marcellus987/mailbox-notification-device/README.md

# Mailbox Notification Device Project
Repository for my Mailbox Notification Device Project. Code for transmitter and receiver are placed under separate folder, namely "tx-" and "rx-".

The drivers used for all the hardware (STM32, SD card, RYLR689, SH1106 OLED display, and DS3231 RTC) used in this project were all ***customly made*** by **myself**. I did this for educational purpose; to practice reading and understanding datasheets.
Therefore, **keep in mind** that the drivers are **not** perfect; however, I did debugged it the best I can including the use of Logic Analyzer to monitor how the drivers interacted with the hardware. With that said, the custom drivers can be found under "custom-drivers" directory which is linked to a separate repository.

**<u>FYI</u>:** This project is currently ***In Progress***.
<hr>

## <u>Pins used (Transmitter STM32-blackpill)</u>:

### RYLR689 LoRa module:
- PA5: SCK
- PA6: MISO
- PA7: MOSI
- PA8: NSS (CS)
- PB0: RF CONTROL: RFSW_V1_PIN_POS
- PB1: RF CONTROL: RFSW_V2_PIN_POS
- PB5: BUSY
- PB8: RESET (Active-Low)
- PB9: DIO (Interrupt)

### IR beam transmitter and receiver sensor:
- PB10: IR beam receiver output (Pull-up required for MCU input pin).
- PB12: IR beam receiver power.
- PB13: IR beam transmitter power.

### For debug:
- PA2: UART TX
- PA3: UART RX
- PC13: User LED for debugging purposes.

<hr>

## <u>Pins used (Receiver STM32-blackpill)</u>:

### RYLR689 LoRa module:
- PA5: SCLK
- PA6: MISO
- PA7: MOSI
- PA8: NSS (CS)
- PB0: RF CONTROL: RFSW_V1_PIN_POS
- PB1: RF CONTROL: RFSW_V2_PIN_POS
- PB5: BUSY
- PB8: RESET (Active-Low)
- PB9: DIO (Interrupt)

### DS3231 (RTC module):
- PB6: SCL
- PB7: SDA

### SD-card module (SPI-based):
- PA1: CS
- PA5: SCLK
- PA6: MISO
- PA7: MOSI

### OLED Display (SPI-based):
- PA4: CS
- PA5: SCLK
- PA7: MOSI
- PB14: DC
- PB15: RESET (Active-Low)

## LED indication lights:
- PB12: Blue LED 
- PB13: Yellow LED
  
### For debug:
- PA2: UART TX
- PA3: UART RX
- PC13: User LED for debugging purposes.

<hr>

# Flow:
- **TBU**: I will update this with an image of a diagram, typing it is not easy.

<hr>

# Demo:

### RX side Image(s):

**<u>Components:<u>**
- STM32F411CEU (blackpill), RYLR689 LoRa module, SD card module, DS3231 RTC module, OLED SH1106 module, Power supply, 9v Battery.
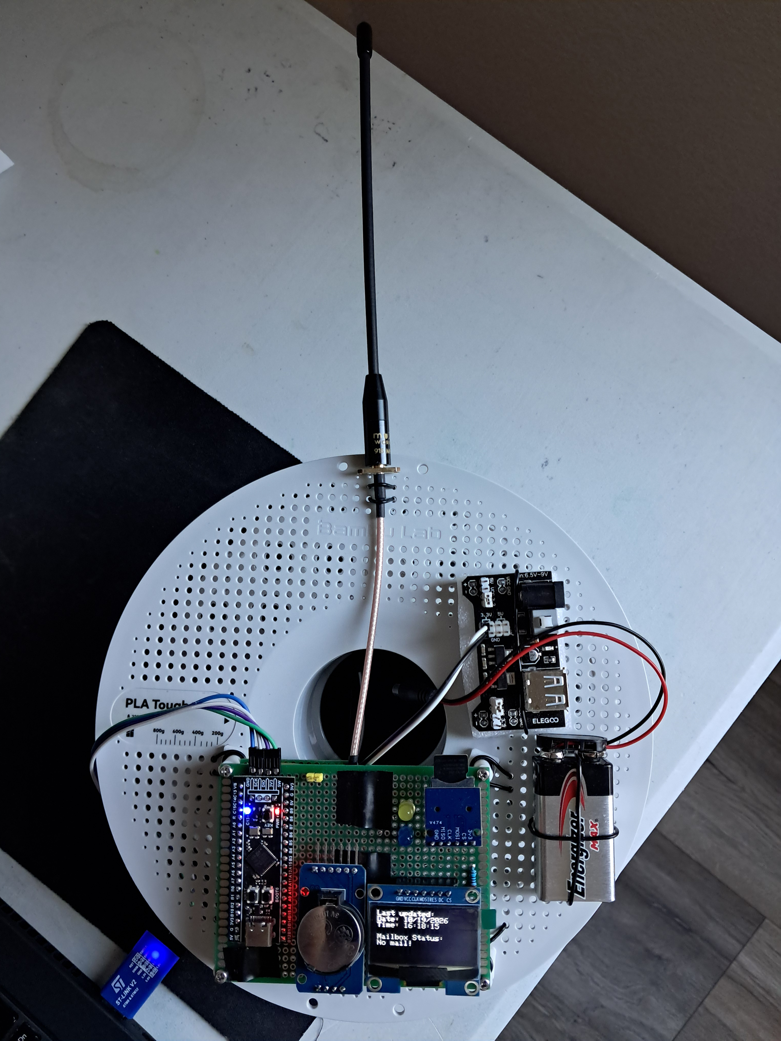
[picture p1: demo/images/rx_device_images/rx-setup.jpg]
Components used for RX device in this project.


**<u>Wirings:<u>**
- ***Note:*** The solder blobs you would see here were intentionally done for better contact.
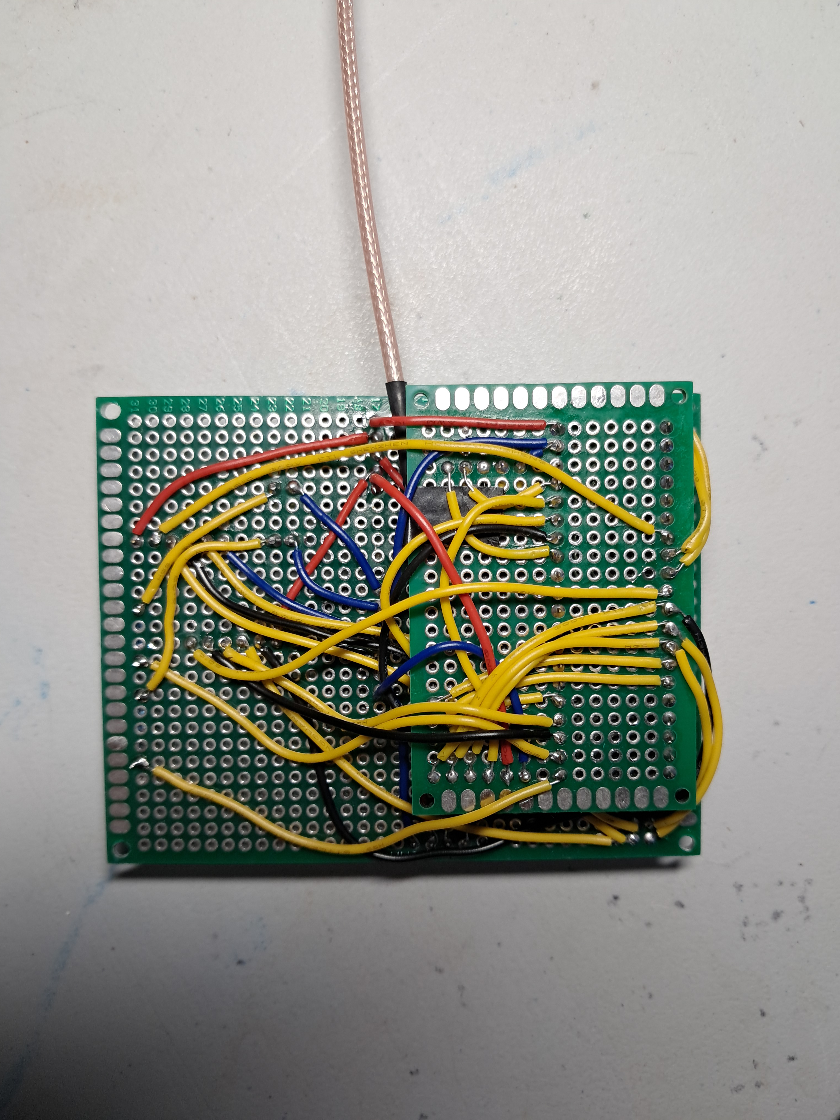
[picture p2: hardware/rx-dev-wirings.jpg]
Wirings of RX device.


**<u>Initial Status: No mail.<u>**
This is initial status at boot.


**<u>Updated Status: New mail arrived!<u>**
This is the demo when new mail arrives.


**<u>Updated Status: Old and possibly new mail inside the mailbox!<u>**
This is the demo when old and possibly new mail is inside the mailbox.


### TX side Image(s):

**<u>Components:<u>**
- STM32F411CEU (blackpill), RYLR689 LoRa module, SD card module, IR transmitter-receiver, Reed switch (Normally open, will be replaced with "Normally closed" version in the future).
- When deployed in an actual Mailbox, the IR sensor will be placed on the sides of the mailbox while the Reed switch will be placed on the mailbox lid to detect when it opens.
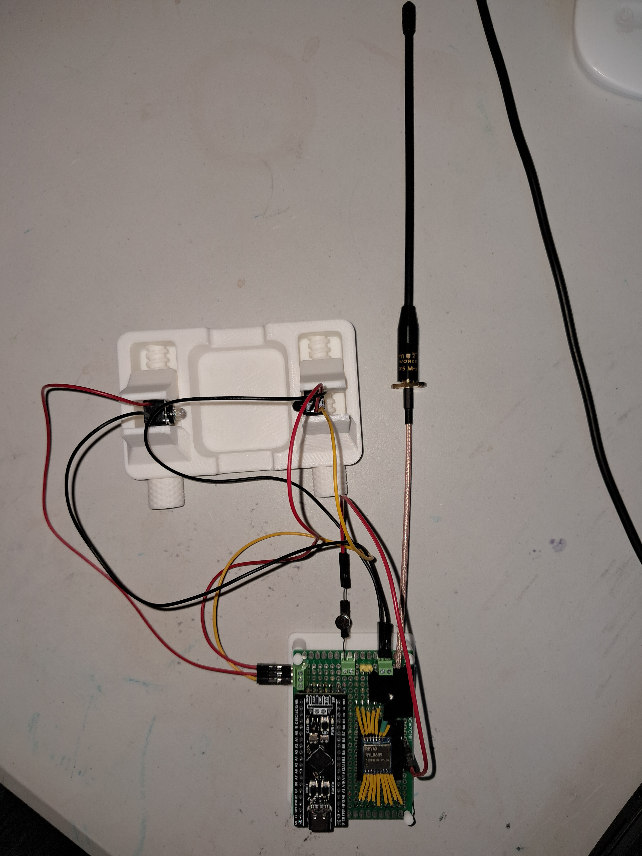
[picture p6: demo/images/tx_device_images/tx_setup.jpg]
Components for TX device used in this project.


**<u>Wirings:<u>**
- ***Note:*** The solder blobs you would see here were intentionally done for better contact.
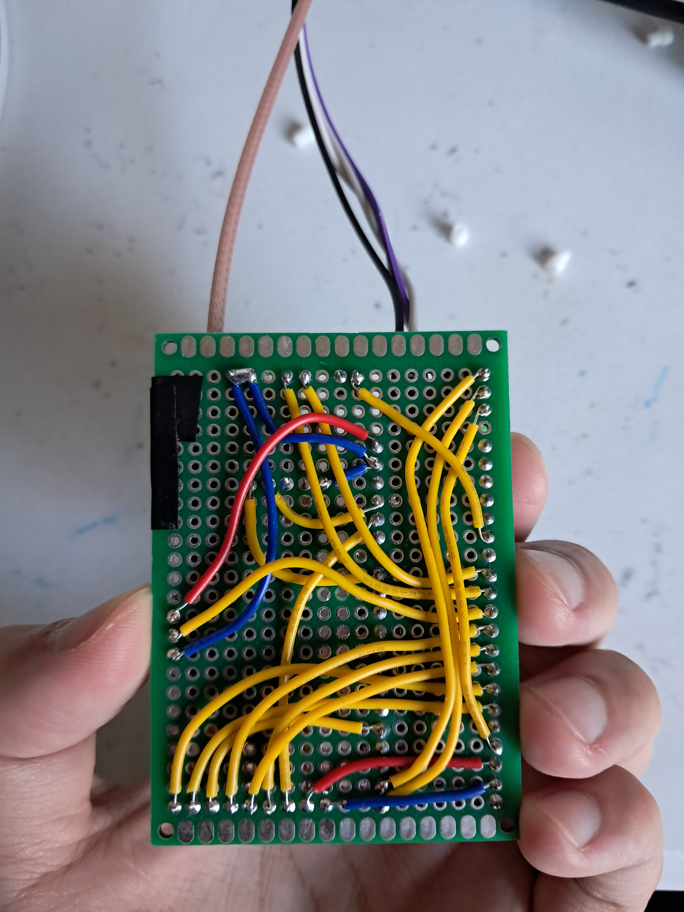
[picture p7: hardware/tx-dev-wirings.jpg]
Wirings of TX device.


**<u>IR-sensor and Reed switch:<u>**
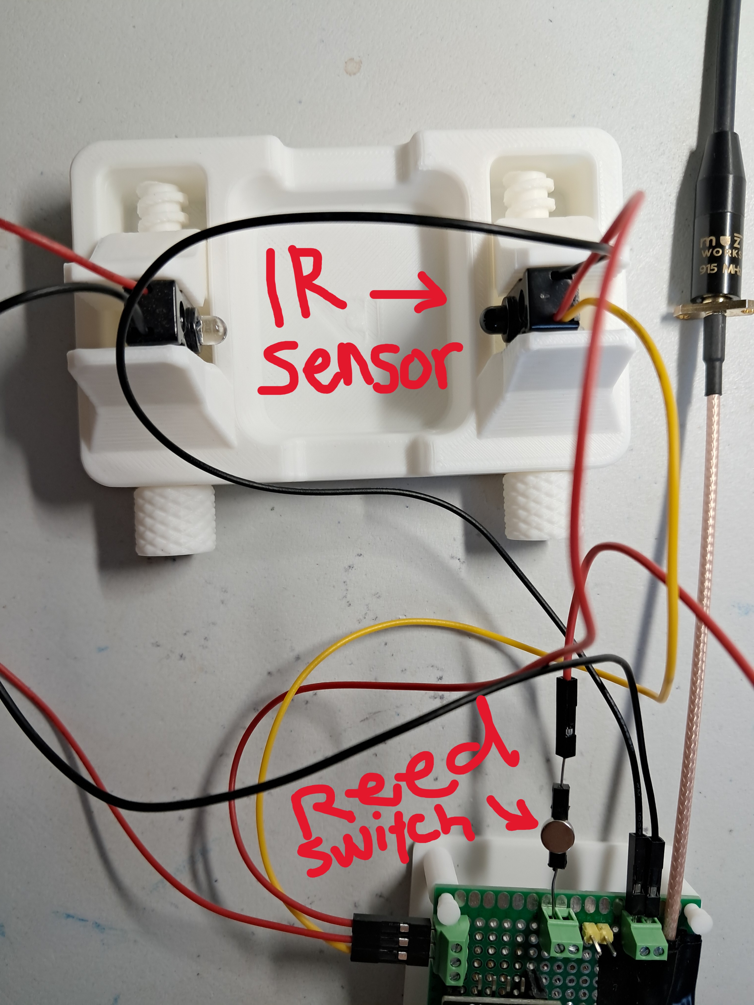
[picture p8: demo/images/tx_device_images/tx_ir_sensor_close_up_md.jpg]
Close-up image of the IR sensor used in this project.


### Video(s):
- **TBU**: I will post a simple demonstration video here.
