marcellus987/mailbox-notification-device/demo/images/tx_device_images/tx_close_up.jpg

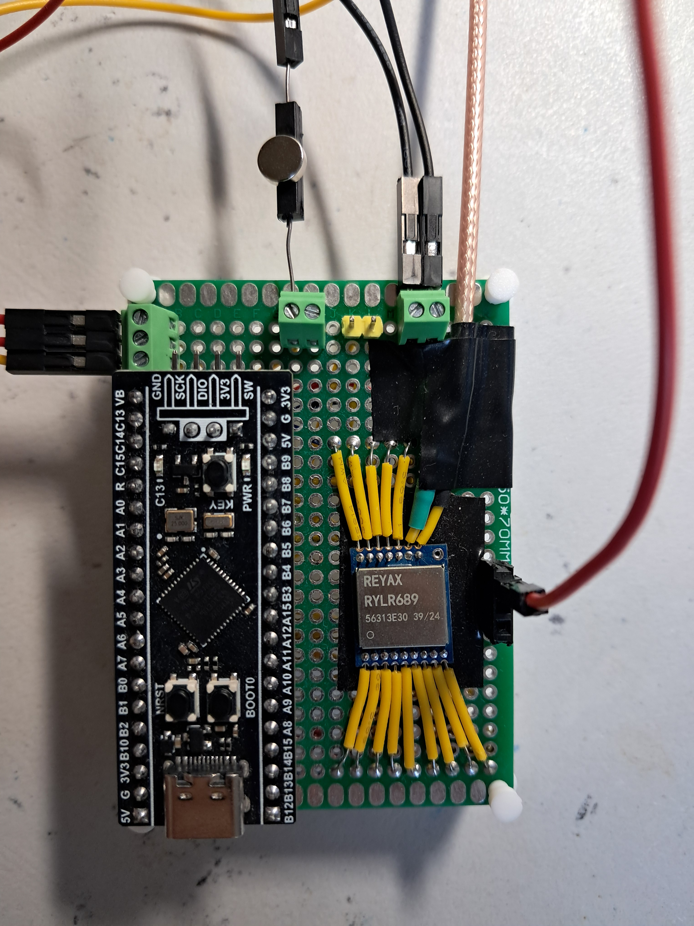
demo/images/tx_device_images/tx_close_up.jpg
