marcellus987/mailbox-notification-device/demo/images/tx_device_images/tx_setup_closeup.jpg

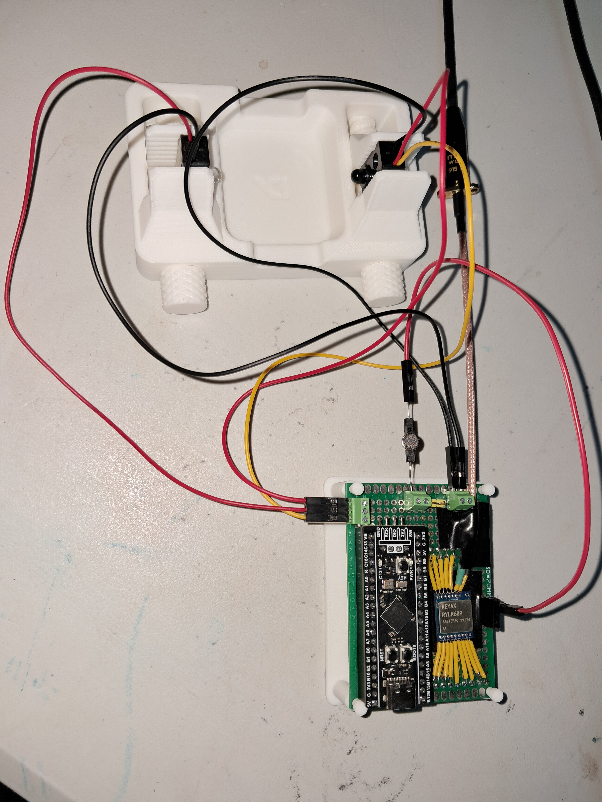
demo/images/tx_device_images/tx_setup_closeup.jpg
