marcellus987/mailbox-notification-device/rx-firmware/Core/Src/main.c

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
/* Includes ------------------------------------------------------------------*/
#include "main.h"

/* USER CODE BEGIN Includes */
#include "rylr689_driver.h"
#include "ds3231_driver.h"
#include "stm32_commons.h"
#include "sdCard_driver.h"
#include "ff.h"
#include "oled_sh1106_driver.h"
#include <string.h>


/* USER CODE END Includes */

/* USER CODE BEGIN PD */
#define LAST_UPDATE_HEADER_LINE		0
#define DATE_HEADER_LINE 			1
#define TIME_HEADER_LINE 			2
#define MAIL_STATUS_HEADER_LINE 	4
#define MAIL_MSG_LINE_START 		5
#define MAIL_MSG_LINE_END 			7
#define MISSED_NOTIFICATION_LIMIT	3
#define RTC_BASE_CENTURY			2000

#define TIME_FORMAT_WIDTH 8 /* HH:MM:SS -> 10 characters. */
#define DATE_FORMAT_WIDTH 10 /* MM:DD:YYYY -> 10 characters. */
#define MAILBOX_RXTX_MAGIC_NUMBER 0xDEADBEEFU

/* USER CODE END PD */

I2C_HandleTypeDef hi2c1;

RTC_HandleTypeDef hrtc;

SPI_HandleTypeDef hspi1;

UART_HandleTypeDef huart2;

/* USER CODE BEGIN PV */

sdCard_instance_t sdCardDev;

/* USER CODE END PV */

void SystemClock_Config(void);
static void MX_GPIO_Init(void);
static void MX_SPI1_Init(void);
static void MX_USART2_UART_Init(void);
static void MX_I2C1_Init(void);
static void MX_RTC_Init(void);
/* USER CODE BEGIN PFP */
static void rylry689_radio_init(rylr689_instance_t *dev, uint8_t *buffer);
static void sh1106_oled_init(oled_sh1106_instance_t *dev);
static void ds3231_rtc_init(ds3231_instance_t *dev);
static void sdCard_global_init(void);
static void syncIntRTCPeriphToExtRTC(ds3231_instance_t *dev);

static void getDateTime(RTC_TimeTypeDef *curTime, RTC_DateTypeDef *curDate);

/* USER CODE END PFP */

/* USER CODE BEGIN 0 */
typedef enum {
	STATE_APP_START = 0,
	STATE_SLEEP_ON_WAIT,
	STATE_ON_RECEIVE
} app_state_t;

typedef enum {
	MAIL_ABSENT = 0,
	MAIL_PRESENT,
	MAIL_MISSED_INITIAL_NOTIFICATION
} mail_state_t;

volatile app_state_t appState = STATE_APP_START;

/* USER CODE END 0 */

/**
  * @brief  The application entry point.
  * @retval int
  */
int main(void)
{

  /* MCU Configuration--------------------------------------------------------*/

  /* Reset of all peripherals, Initializes the Flash interface and the Systick. */
  HAL_Init();

  /* Configure the system clock */
  SystemClock_Config();

  /* Initialize all configured peripherals */
  MX_GPIO_Init();
  MX_SPI1_Init();
  MX_USART2_UART_Init();
  MX_I2C1_Init();
  MX_RTC_Init();
  /* USER CODE BEGIN 2 */

	/* Oled module START. */
	oled_sh1106_instance_t oled1;
	sh1106_oled_init(&oled1);
	/* Oled module END. */

	/* RTC module START. */
	ds3231_instance_t rtc1;
	ds3231_rtc_init(&rtc1);
	/* Update MCU RTC peripheral to avoid constantly querying ds3231 module. */
	syncIntRTCPeriphToExtRTC(&rtc1);

	RTC_TimeTypeDef curTime = {0};
	RTC_DateTypeDef curDate = {0};
	getDateTime(&curTime, &curDate);
	/* RTC module END. */

    /* SD card module START. */
	sdCard_global_init(); /* Initialize SD card. */

	FATFS fs;   /* File system. */
	FIL file;   /* File handler. */
	FRESULT res; /* Result from file function calls. */
	UINT br; /* Bytes read from file. */
	UINT bw; /* Bytes written to file. */


	/* Original files will have only the date stamp. If this file exist but the header
	 * did not match, create a new file with time stamp.
	 *
	 * The limitation is that when the original fails. Then each boot up for the current
	 * date will create new files with new time stamp. To avoid this, one possible solution
	 * is to create a backup file for failing files, then reuse the original filename. This way
	 * file creation can be reduced. The down-side is that creating a backup may take time if
	 * original file is large.
	 *
	 * */
	char filename[30];
	char header[] = "Date: [mm-dd-yyyy],Time (24-hour format): [hh-mm-ss],Status:\r\n";
	uint32_t headerLen = strlen(header);

	res = f_mount(&fs, "",0);

	snprintf(filename, 29, "mailbox_log_%04u-%02u-%02u.csv", \
			(curDate.Year + RTC_BASE_CENTURY), curDate.Month, curDate.Date);
	uint32_t startTime = HAL_GetTick();

	/* Open file for current date. */
	while((res = f_open(&file, filename, FA_WRITE | FA_READ | FA_OPEN_APPEND)) != FR_OK) {
		if((HAL_GetTick() - startTime) > SD_TIMEOUT) {
			char *errMsg = "SD card error! Failed to mount file system!";
			sh1106_setAtCharacter(&oled1, LAST_UPDATE_HEADER_LINE, 0);
			sh1106_write_line(&oled1, errMsg, strlen(errMsg));
			Error_Handler();
		}
	}

	/* Check if file is empty. If not check if header exist. */
	if(f_size(&file) > 0) {
		char testRead[headerLen];
		/* Set cursor to beginning. Then perform a read. */
		f_lseek(&file, 0);
		res = f_read(&file, testRead, headerLen, &br);

		/* 1st Method of handling failing files. */
		/* No matching header. Create new file for same date but with timestamp. */
		if(memcmp((char*)testRead, header, headerLen) != 0) {
			FIL tempFile;
			char tempFilename[FF_MAX_LFN];
			uint8_t readBuff[512];
			UINT bytesRead;
			UINT bytesWritten;
			FSIZE_t bytesCopied = 0;
			FSIZE_t bytesRemaining = f_size(&file); /* Though f_size() returns uint64_t, it may be unrealistic
																	  for a CSV file to be that large. So, only the lower 32-bit
																	  will be used for now. */

			char msgDspBuff[50] = "Error with log file! Performing backup...";
			char *bytesRemHeader = "Bytes remaining: ";
			char *bytesCopHeader = "Bytes copied: ";

			uint8_t oldBytesRemValBuffLen;
			uint8_t oldBytesCopValBuffLen;

			sh1106_setAtCharacter(&oled1, LAST_UPDATE_HEADER_LINE, 0);
			sh1106_write_line(&oled1, msgDspBuff, strlen(msgDspBuff));

			/* Line #2. */
			sprintf(msgDspBuff, "File size: %lu", (uint32_t)bytesRemaining);
			sh1106_setAtCharacter(&oled1, LAST_UPDATE_HEADER_LINE + 2, 0);
			sh1106_write_line(&oled1, msgDspBuff, strlen(msgDspBuff));

			/* Line #4. */
			sh1106_setAtCharacter(&oled1, LAST_UPDATE_HEADER_LINE + 3, 0);
			sh1106_write_line(&oled1, bytesRemHeader, strlen(bytesRemHeader));
			sprintf(msgDspBuff, "%lu", (uint32_t)bytesRemaining);
			sh1106_setAtCharacter(&oled1, LAST_UPDATE_HEADER_LINE + 4, 0);
			sh1106_write_line(&oled1, msgDspBuff, strlen(msgDspBuff));
			oldBytesRemValBuffLen = strlen(msgDspBuff);

			/* Line #5. */
			sh1106_setAtCharacter(&oled1, LAST_UPDATE_HEADER_LINE + 5, 0);
			sh1106_write_line(&oled1, bytesCopHeader, strlen(bytesCopHeader));
			sprintf(msgDspBuff, "%lu", (uint32_t)bytesCopied);
			sh1106_setAtCharacter(&oled1, LAST_UPDATE_HEADER_LINE + 6, 0);
			sh1106_write_line(&oled1, msgDspBuff, strlen(msgDspBuff));
			oldBytesCopValBuffLen = strlen(msgDspBuff);

			getDateTime(&curTime, &curDate);

			/* Filename format: mail_log_YYYY-MM-DD_hh-mm-ss.csv. */
			snprintf(tempFilename, FF_MAX_LFN, "bak_failing_log_%04u-%02u-%02u_%02u-%02u-%02u.csv", \
					(curDate.Year + RTC_BASE_CENTURY), curDate.Month, curDate.Date, \
					 curTime.Hours, curTime.Minutes, curTime.Seconds);

			f_open(&tempFile, tempFilename, (FA_WRITE | FA_READ | FA_OPEN_APPEND));

			/* Set cursor to beginning of original file. Then perform a read. */
			f_lseek(&file, 0);

			while(bytesRemaining > bytesCopied) {
				f_read(&file, readBuff, 512, &bytesRead);
				f_write(&tempFile, readBuff, bytesRead, &bytesWritten);
				f_sync(&tempFile);
				bytesCopied += bytesWritten;

				/* Display bytes remaining to be copied. */
				sprintf(msgDspBuff, "%lu", (uint32_t)(bytesRemaining - bytesCopied));


				if(oldBytesRemValBuffLen > strlen(msgDspBuff)) {
				  memset((msgDspBuff + strlen(msgDspBuff)), ' ', oldBytesRemValBuffLen - strlen(msgDspBuff));
				}
				sh1106_setAtCharacter(&oled1, LAST_UPDATE_HEADER_LINE + 4, 0);
				sh1106_write_line(&oled1, msgDspBuff, strlen(msgDspBuff));

				/* Display bytes copied. */
				sprintf(msgDspBuff, "%lu", (uint32_t)bytesCopied);
				if(oldBytesCopValBuffLen > strlen(msgDspBuff)) {
				  memset((msgDspBuff + strlen(msgDspBuff)), ' ', oldBytesCopValBuffLen - strlen(msgDspBuff));
				}
				sh1106_setAtCharacter(&oled1, LAST_UPDATE_HEADER_LINE + 6, 0);
				sh1106_write_line(&oled1, msgDspBuff, strlen(msgDspBuff));
			}
			sh1106_clearScreen(&oled1);

			f_close(&tempFile);

			/* Set cursor to beginning of original file. Then delete its contents, keeping file open. */
			f_lseek(&file, 0);
			f_truncate(&file);
			f_write(&file, header, headerLen, &bw);
			f_sync(&file);
		}
		else {
			/* Move back the cursor to EOF. To prepare for possible file write operations. */
			f_lseek(&file, f_size(&file));
		}

//		/* 2nd method. */
//		/* No matching header. Create new file for same date but with timestamp. */
//		if(memcmp((char*)testRead, header, headerLen) != 0) {
//			f_close(&file); /* Close current file. */
//
//			char tempFilename[FF_MAX_LFN];
//			getDateTime(&curTime, &curDate);
//			/* Filename format: mail_log_YYYY-MM-DD_hh-mm-ss.csv. */
//			snprintf(tempFilename, FF_MAX_LFN, "mailbox_log_%04u-%02u-%02u_%02u-%02u-%02u.csv", \
//					(curDate.Year + RTC_BASE_CENTURY), curDate.Month, curDate.Date, \
//					 curTime.Hours, curTime.Minutes, curTime.Seconds);
//			f_open(&file, tempFilename, (FA_WRITE | FA_READ | FA_OPEN_APPEND));
//			res = f_write(&file, header, headerLen, &bw);
//			f_sync(&file);
//		}
//		else {
//			/* Move back the cursor to EOF. To prepare for possible file write operations. */
//			f_lseek(&file, fileSize);
//		}
	}
	else {
		res = f_write(&file, header, headerLen, &bw);
		f_sync(&file);
	}

//	/* For debug. */
//	f_close(&file);
//	HAL_GPIO_WritePin(YELLOW_LED_GPIO_Port, YELLOW_LED_Pin, GPIO_PIN_SET);
//	HAL_GPIO_WritePin(BLUE_LED_GPIO_Port, BLUE_LED_Pin, GPIO_PIN_SET);
	/* SD card module END. */

	HAL_GPIO_WritePin(BUILT_IN_LED_GPIO_Port, BUILT_IN_LED_Pin, GPIO_PIN_RESET);

	/* Radio module START. */
	uint8_t status[256];
	rylr689_instance_t radio1;
	rylry689_radio_init(&radio1, status);
	uint32_t packetSizeReceived;
	/* Radio module END. */


	char msg[50];

	/* +1 for null character. */
	char dateBuff[DATE_FORMAT_WIDTH + 1];
	char timeBuff[TIME_FORMAT_WIDTH + 1];

	char* lastUpdateHeader = "Last updated:";
	char *dateHeader = "Date: ";
	char *timeHeader = "Time: ";
	char *mailHeader = "Mailbox Status: ";

	/* Write headers to designated lines. */
	sh1106_setAtCharacter(&oled1, LAST_UPDATE_HEADER_LINE, 0);
	sh1106_write_line(&oled1, lastUpdateHeader, strlen(lastUpdateHeader));

	sh1106_setAtCharacter(&oled1, DATE_HEADER_LINE, 0);
	sh1106_write_line(&oled1, dateHeader, strlen(dateHeader));

	sh1106_setAtCharacter(&oled1, TIME_HEADER_LINE, 0);
	sh1106_write_line(&oled1, timeHeader, strlen(timeHeader));

	sh1106_setAtCharacter(&oled1, MAIL_STATUS_HEADER_LINE, 0);
	sh1106_write_line(&oled1, mailHeader, strlen(mailHeader));

	snprintf(dateBuff, DATE_FORMAT_WIDTH + 1,"%02u/%02u/%04u", curDate.Month, curDate.Date, (uint16_t)curDate.Year + RTC_BASE_CENTURY);
	snprintf(timeBuff, TIME_FORMAT_WIDTH + 1, "%02u:%02u:%02u", curTime.Hours, curTime.Minutes, curTime.Seconds);

	/* Go back to date line. */
	sh1106_setAtCharacter(&oled1, DATE_HEADER_LINE, strlen(dateHeader));
	sh1106_write_line(&oled1, dateBuff, strlen(dateBuff));

	/* Go back to time line. */
	sh1106_setAtCharacter(&oled1, TIME_HEADER_LINE, strlen(timeHeader));
	sh1106_write_line(&oled1, timeBuff, strlen(timeBuff));

	/* Go to message line. */
	sh1106_setAtCharacter(&oled1, MAIL_MSG_LINE_START, 0);

	sprintf(msg, "No mail!");
	sh1106_write_line(&oled1, msg, strlen(msg));

	uint8_t oldStatus = MAIL_ABSENT;
	uint8_t oldMsgLen = strlen(msg);
	RTC_DateTypeDef savedDate = curDate;



  /* USER CODE END 2 */

  /* Infinite loop */
  /* USER CODE BEGIN WHILE */

  while (1) {
	  switch(appState) {
		  case STATE_APP_START:
			  rylr689_radio_receive_it(&radio1);
			  appState = STATE_SLEEP_ON_WAIT;
			  break;
		  case STATE_SLEEP_ON_WAIT:
			  /* Put device to sleep. Do not change the status here. Only ISR can change the status upon receiving packet.
			   * For now, radio will be ON while MCU is in STOP mode waiting for interrupt from radio. */

			  /* Set to STOP mode here. MCU may wake up from non-radio related wake-up signal, but will be
			   * handled by the application's state.  */
//			  enterStopMode();
//
//			  /* Sleeps... */
//
//			  /* Recover*/
//			  SystemClock_Config();
//			  HAL_ResumeTick();
//
//			  /* Clear wake up flag for clean sleep state after waking. */
//			  clearWakeUpFlags();

			  break;
		  case STATE_ON_RECEIVE:

			  /* Fetch packet. */
			  rylr689_radio_get_packet(&radio1, &packetSizeReceived);

			  /* Packet must be 5 bytes. */
			  if(packetSizeReceived != sizeof(uint32_t) + 1) {
				  Error_Handler();
			  }

			  uint32_t magicVal;
			  /* Skip first bytes then copy the last four bytes. */
			  memcpy(&magicVal, radio1.rxBuff + 1, sizeof(uint32_t));

			  if(magicVal != MAILBOX_RXTX_MAGIC_NUMBER) {
				  Error_Handler();
			  }

			  getDateTime(&curTime, &curDate);
			  /* Update date only when it is different. */
			  if((curDate.Month != savedDate.Month) || (curDate.Date != savedDate.Date ) || (curDate.Year != savedDate.Year)) {
				  	  savedDate = curDate;
					  /* Go back to Date header line. */
					  sh1106_setAtCharacter(&oled1, DATE_HEADER_LINE, strlen(dateHeader));
					  snprintf(dateBuff, DATE_FORMAT_WIDTH + 1,"%02u/%02u/%04u", curDate.Month, curDate.Date, (uint16_t)curDate.Year + RTC_BASE_CENTURY);
					  sh1106_write_line(&oled1, dateBuff, DATE_FORMAT_WIDTH);
			  }

			  /* Go back to Time header line and update time every second. */
			  sh1106_setAtCharacter(&oled1, TIME_HEADER_LINE, strlen(timeHeader));
			  snprintf(timeBuff, TIME_FORMAT_WIDTH + 1, "%02u:%02u:%02u", curTime.Hours, curTime.Minutes, curTime.Seconds);
			  sh1106_write_line(&oled1, timeBuff, TIME_FORMAT_WIDTH);

			  /* Check mailbox status. */
			  switch(status[0]) {
				  case 0:
					  sprintf(msg, "No mail!");
					  HAL_GPIO_WritePin(YELLOW_LED_GPIO_Port, YELLOW_LED_Pin, GPIO_PIN_SET);
					  HAL_GPIO_WritePin(BLUE_LED_GPIO_Port, BLUE_LED_Pin, GPIO_PIN_RESET);
					  break;
				  case 1:
					  sprintf(msg, "New mail arrived!");
					  HAL_GPIO_WritePin(YELLOW_LED_GPIO_Port, YELLOW_LED_Pin, GPIO_PIN_RESET);
					  HAL_GPIO_WritePin(BLUE_LED_GPIO_Port, BLUE_LED_Pin, GPIO_PIN_SET);
					  break;
				  case 2:
					  sprintf(msg, "Old and possibly new mail inside mailbox!");
					  HAL_GPIO_WritePin(YELLOW_LED_GPIO_Port, YELLOW_LED_Pin, GPIO_PIN_SET);
					  HAL_GPIO_WritePin(BLUE_LED_GPIO_Port, BLUE_LED_Pin, GPIO_PIN_SET);
					  break;
				  default:
					  /* For testing only. */
					  sprintf(msg, "False alarm!");
					  HAL_GPIO_WritePin(YELLOW_LED_GPIO_Port, YELLOW_LED_Pin, GPIO_PIN_RESET);
					  HAL_GPIO_WritePin(BLUE_LED_GPIO_Port, BLUE_LED_Pin, GPIO_PIN_RESET);
			  }
			  /* For debug. */
			  HAL_UART_Transmit(&huart2, (uint8_t*)msg, strlen(msg), 100);

			  char log[101];
			  snprintf(log, 100, "%02u/%02u/%04u,%02u:%02u:%02u,%s\r\n", \
					   curDate.Month, curDate.Date, (uint16_t)curDate.Year + RTC_BASE_CENTURY, \
					   curTime.Hours, curTime.Minutes, curTime.Seconds, msg);

			  f_write(&file, log, strlen(log), &bw);
			  f_sync(&file);

			/* Go to message line. Update only if status has changed.*/
			if(status[0] != oldStatus) {
				uint8_t newMsgLen = strlen(msg);

				/* For erasing left-over characters from old message, if necessary. */
				if(oldMsgLen > newMsgLen) {
					memset((msg + newMsgLen), ' ', oldMsgLen - newMsgLen);
				}

				/* Set cursor for the new message and write new message. */
				sh1106_setAtCharacter(&oled1, MAIL_MSG_LINE_START, 0);
				sh1106_write_line(&oled1, msg, (oldMsgLen > newMsgLen) ? oldMsgLen : newMsgLen);

				/* Update "new" old. */
				oldStatus = status[0];
				oldMsgLen = newMsgLen;
			}
			/* Reset state. */
			appState = STATE_APP_START;
			break;
		  default:
			  /* Do nothing. */
	  }
  }

    /* USER CODE END WHILE */

}

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
/* USER CODE BEGIN 4 */

/* For FATFS. */
DWORD get_fattime (void) {
	RTC_TimeTypeDef curTime;
	RTC_DateTypeDef curDate;
	getDateTime(&curTime, &curDate);

	return (((curDate.Year + RTC_BASE_CENTURY) - 1980) << 25) | \
			(curDate.Month << 21) | (curDate.Date << 16) | \
			(curTime.Hours << 11) | (curTime.Minutes << 5) | \
			(curTime.Seconds >> 1);
}



static void getDateTime(RTC_TimeTypeDef *curTime, RTC_DateTypeDef *curDate) {
	/* Must be called in sequence per HAL documentation.
	 * The RTC_FORMAT_BIN converts the native BCD format to binary
	 * representation of the value. This will give us the actual
	 * number for each field. */
	HAL_RTC_GetTime(&hrtc, curTime, RTC_FORMAT_BIN);
	HAL_RTC_GetDate(&hrtc, curDate, RTC_FORMAT_BIN);
}

static void sdCard_global_init(void) {
	sdCardDev.csPin.port = SD_CARD_CS_GPIO_Port;
	sdCardDev.csPin.pin = SD_CARD_CS_Pin;
	sdCardDev.pinRead = wrapper_pin_read;
	sdCardDev.pinWrite = wrapper_pin_write;
	sdCardDev.delay = wrapper_delay;
	sdCardDev.spiHandle = &hspi1;
	sdCardDev.spiTransmitReceive = wrapper_spi_transmit_receive;
	sdCardDev.spiTransmit = wrapper_spi_transmit;
	sdCardDev.getState = wrapper_get_spi_state;
	sdCardDev.setBaudrate = wrapper_sdCard_spi_setBaudrate;
	sdCardDev.initialized = 0;

	xSd_Init(&sdCardDev);
}

static void rylry689_radio_init(rylr689_instance_t *dev, uint8_t *buffer) {
	dev->csPin.pin = LoRa_Module_CS_Pin;
	dev->csPin.port = LoRa_Module_CS_GPIO_Port;
	dev->busyPin.pin = LoRa_Module_Busy_Pin;
	dev->busyPin.port = LoRa_Module_Busy_GPIO_Port;
	dev->nresetPin.pin = LoRa_Module_NRESET_Pin;
	dev->nresetPin.port = LoRa_Module_NRESET_GPIO_Port;
	dev->itPin.pin = LoRa_Module_DIOQ_Pin;
	dev->itPin.port = LoRa_Module_DIOQ_GPIO_Port;
	dev->rfswV1Pin.pin = LoRa_Module_RFSW_V1_PIN_POS_Pin;
	dev->rfswV1Pin.port = LoRa_Module_RFSW_V1_PIN_POS_GPIO_Port;
	dev->rfswV2Pin.pin = LoRa_Module_RFSW_V2_PIN_POS_Pin;
	dev->rfswV2Pin.port = LoRa_Module_RFSW_V2_PIN_POS_GPIO_Port;
	dev->pinWrite = wrapper_pin_write;
	dev->pinRead = wrapper_pin_read;
	dev->spiHandle = &hspi1;
	dev->spiReceive = wrapper_spi_receive;
	dev->spiTransmit = wrapper_spi_transmit;
	dev->rxBuff = buffer;
	dev->rxBuffSize = RX_BUFF_SIZE;
	dev->txBuff = buffer;
	dev->txBuffSize = TX_BUFF_SIZE;
	dev->initialized = 0;

	rylr689_radio_init(dev);

}
static void sh1106_oled_init(oled_sh1106_instance_t *dev) {
	dev->cs.port = OLED_CS_GPIO_Port;
	dev->cs.pin = OLED_CS_Pin;
	dev->dc.port = OLED_DC_GPIO_Port;
	dev->dc.pin = OLED_DC_Pin;
	dev->nreset.port = OLED_NRESET_GPIO_Port;
	dev->nreset.pin = OLED_NRESET_Pin;
	dev->gpio_write = wrapper_pin_write;
	dev->delay_ms = wrapper_delay;
	dev->spiHandle = &hspi1;
	dev->spiTransmit = wrapper_spi_transmit;
	dev->initialized = 0;

	sh1106_init(dev);
}

static void ds3231_rtc_init(ds3231_instance_t *dev) {
	dev->i2cHandle = &hi2c1;
	dev->i2cTransmit = wrapper_i2c_transmit_repeat_start;
	dev->i2cReceive = wrapper_i2c_receive_repeat_start;
	dev->baseCentury = RTC_BASE_CENTURY;
	dev->initialized = 0;

	ds3231_rtc_module_init(dev);
}

static void syncIntRTCPeriphToExtRTC(ds3231_instance_t *dev) {

	RTC_TimeTypeDef sTime = {0};
	RTC_DateTypeDef sDate = {0};
	raw_date_t rDate;
	raw_time_t rTime;

	/* Already in BCD, when calling HAL, use the RTC_FORMAT_BCD option. */
	ds3231_getRawCurrentDate(dev, &rDate);
	ds3231_getRawCurrentTime(dev, &rTime);

	sTime.Hours = rTime.hours;
	sTime.Minutes = rTime.minutes;
	sTime.Seconds = rTime.seconds;
	sTime.DayLightSaving = RTC_DAYLIGHTSAVING_NONE;
	sTime.StoreOperation = RTC_STOREOPERATION_RESET;

	if (HAL_RTC_SetTime(&hrtc, &sTime, RTC_FORMAT_BCD) != HAL_OK)
	{
		Error_Handler();
	}

	sDate.WeekDay = rDate.dayOfWeek;
	sDate.Month = rDate.month;
	sDate.Date = rDate.date;
	sDate.Year = rDate.year;

	if (HAL_RTC_SetDate(&hrtc, &sDate, RTC_FORMAT_BCD) != HAL_OK)
	{
		Error_Handler();
	}
}



void HAL_GPIO_EXTI_Callback(uint16_t GPIO_Pin) {
//	UNUSED(GPIO_Pin);
	appState = STATE_ON_RECEIVE;
}
/* USER CODE END 4 */
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
