marcellus987/mailbox-notification-device/tx-firmware/Core/Inc/main.h

#define BUILT_IN_LED_Pin GPIO_PIN_13
#define BUILT_IN_LED_GPIO_Port GPIOC
#define LoRa_Module_RFSW_V1_PIN_POS_Pin GPIO_PIN_0
#define LoRa_Module_RFSW_V1_PIN_POS_GPIO_Port GPIOB
#define LoRa_Module_RFSW_V2_PIN_POS_Pin GPIO_PIN_1
#define LoRa_Module_RFSW_V2_PIN_POS_GPIO_Port GPIOB
#define IR_BEAM_OUT_Pin GPIO_PIN_10
#define IR_BEAM_OUT_GPIO_Port GPIOB
#define IR_BEAM_REC_PWR_Pin GPIO_PIN_12
#define IR_BEAM_REC_PWR_GPIO_Port GPIOB
#define IR_BEAM_TRANS_PWR_Pin GPIO_PIN_13
#define IR_BEAM_TRANS_PWR_GPIO_Port GPIOB
#define LoRa_Module_CS_pin_Pin GPIO_PIN_8
#define LoRa_Module_CS_pin_GPIO_Port GPIOA
#define LoRa_Module_Busy_pin_Pin GPIO_PIN_5
#define LoRa_Module_Busy_pin_GPIO_Port GPIOB
#define LoRa_Module_NRESET_pin_Pin GPIO_PIN_8
#define LoRa_Module_NRESET_pin_GPIO_Port GPIOB
#define LoRa_Module_DIOQ_Pin_Pin GPIO_PIN_9
#define LoRa_Module_DIOQ_Pin_GPIO_Port GPIOB
