marcellus987/mailbox-notification-device/(commit log)

2026-10-14 Linked custom-drivers repo.
2026-10-20 Added description for the drivers used in this project.
2026-10-20 Modified description for the drivers used in this project.
2026-10-20 Fixed description for the drivers used in this project.
