marcellus987/mailbox-notification-device/demo/images/rx_device_images/rx-no-mail-demo.jpg

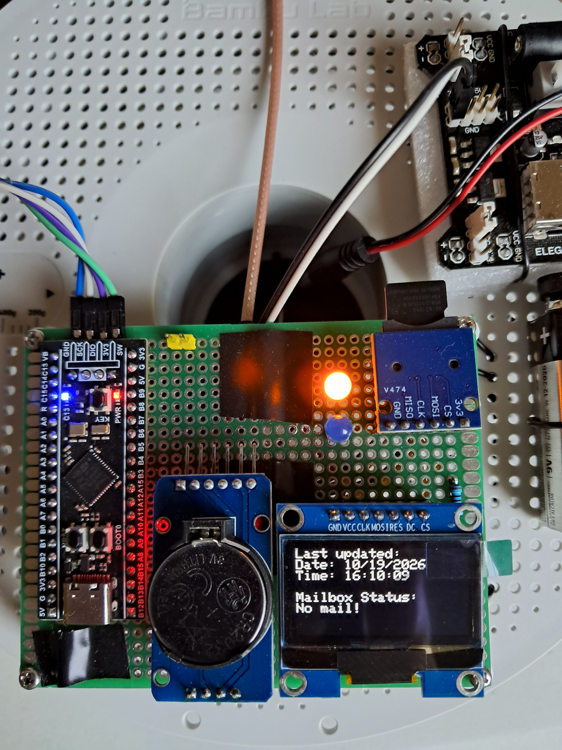
[picture p3: demo/images/rx_device_images/rx-no-mail-demo.jpg]
demo/images/rx_device_images/rx-no-mail-demo.jpg
