marcellus987/mailbox-notification-device/demo/images/rx_device_images/rx-new-mail-demo.jpg

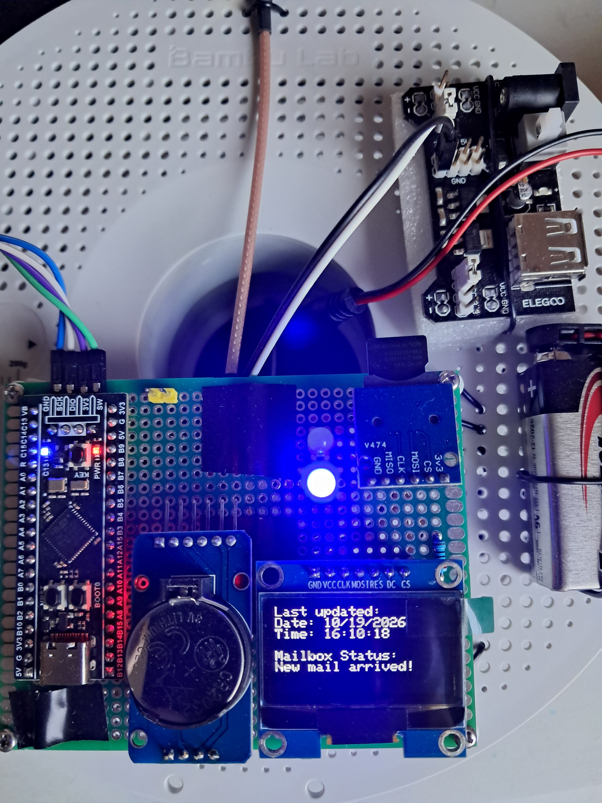
[picture p4: demo/images/rx_device_images/rx-new-mail-demo.jpg]
demo/images/rx_device_images/rx-new-mail-demo.jpg
