marcellus987/mailbox-notification-device/demo/images/rx_device_images/rx-old-new-demo.jpg

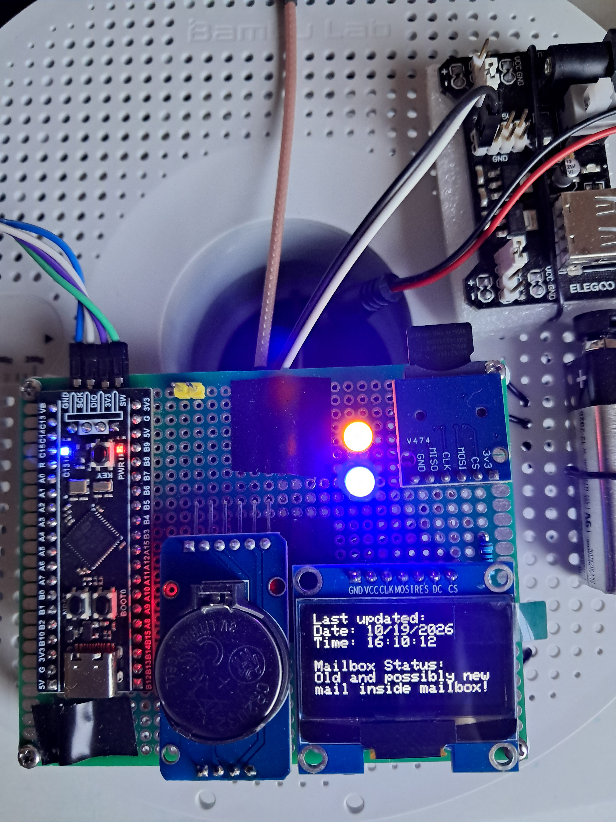
[picture p5: demo/images/rx_device_images/rx-old-new-demo.jpg]
demo/images/rx_device_images/rx-old-new-demo.jpg
